smwo240/sensetech-wallv2/schematics/Air Module Schematic.jpg

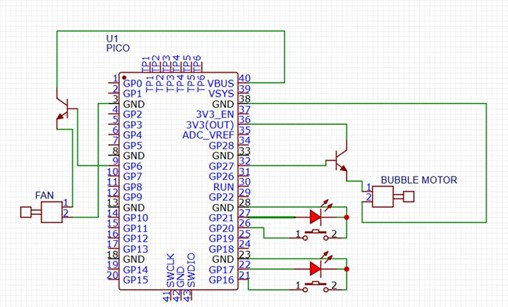
schematics/Air Module Schematic.jpg
