smwo240/sensetech-wallv2/README.md

# sensetech-wallv2
Project for University of Kentucky ECE Senior Design Course. Module Sensory Wall by Team 09 SenseTech.
