smwo240/sensetech-wallv2/schematics/README.txt

These are the schematics for the final version of this project presented at University of Kentucky's senior design day. 
The code reflects the usage of the pin mappings and devices present.
