smwo240/sensetech-wallv2/schematics/Light Module Schematic.jpg

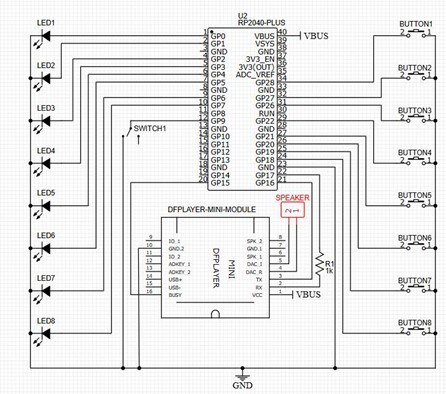
schematics/Light Module Schematic.jpg
