smwo240/sensetech-wallv2/schematics/Sound Module Schematic.png

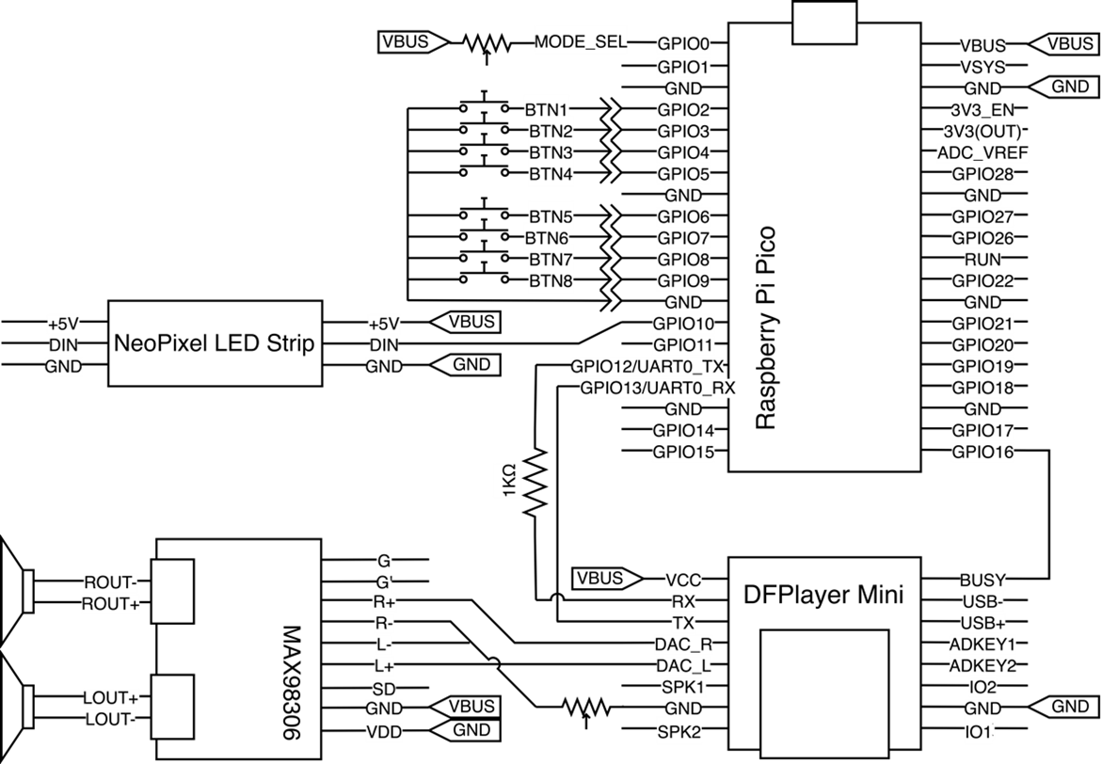
schematics/Sound Module Schematic.png
