smwo240/sensetech-wallv2/schematics/Vibration Module Schematic.png

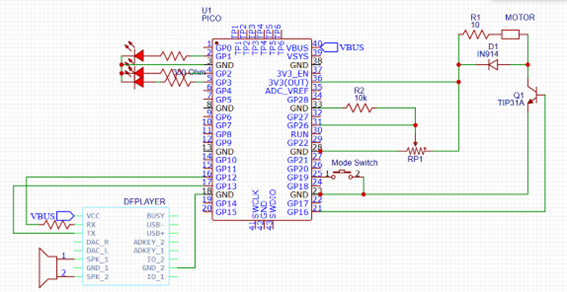
schematics/Vibration Module Schematic.png
