smwo240/sensetech-wallv2/3d-assets/Spring Holder Outer.stl

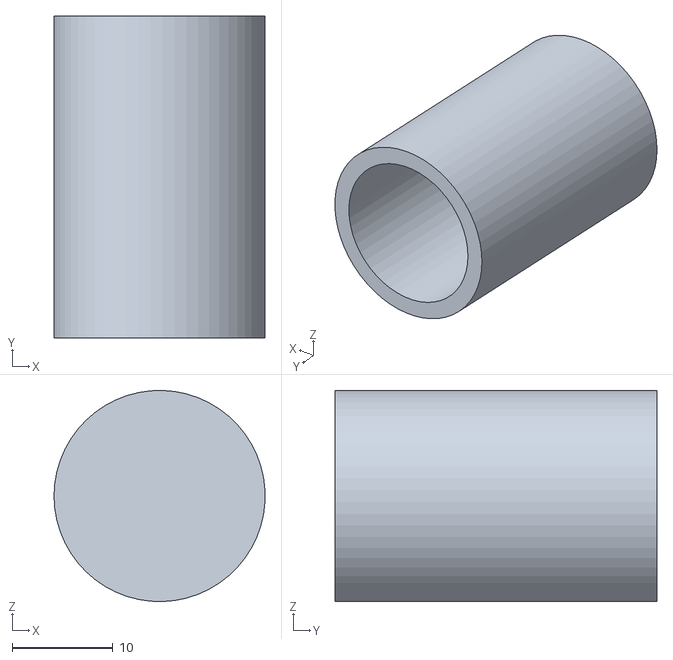
[picture p5: CAD file, 2025-05-11]
3d-assets/Spring Holder Outer.stl
21.0 x 32.0 x 21.0
