smwo240/sensetech-wallv2/3d-assets/SenseTechTopPlatev2.STL

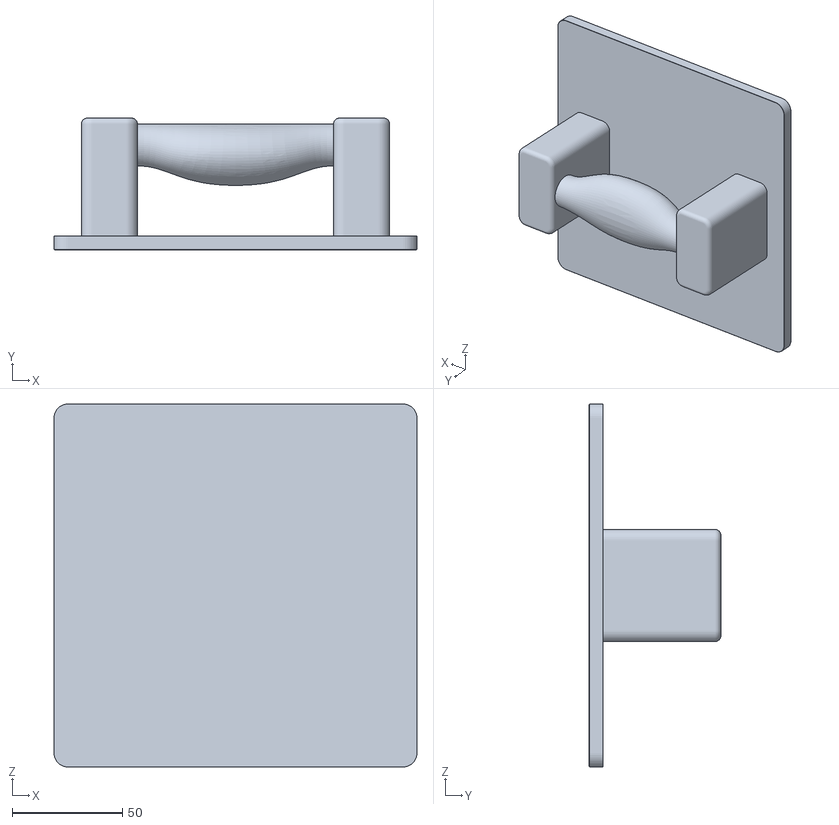
[picture p6: CAD file, 2025-05-11]
3d-assets/SenseTechTopPlatev2.STL
164.6 x 59.7 x 164.6
