smwo240/sensetech-wallv2/3d-assets/Motor Mount V2.stl

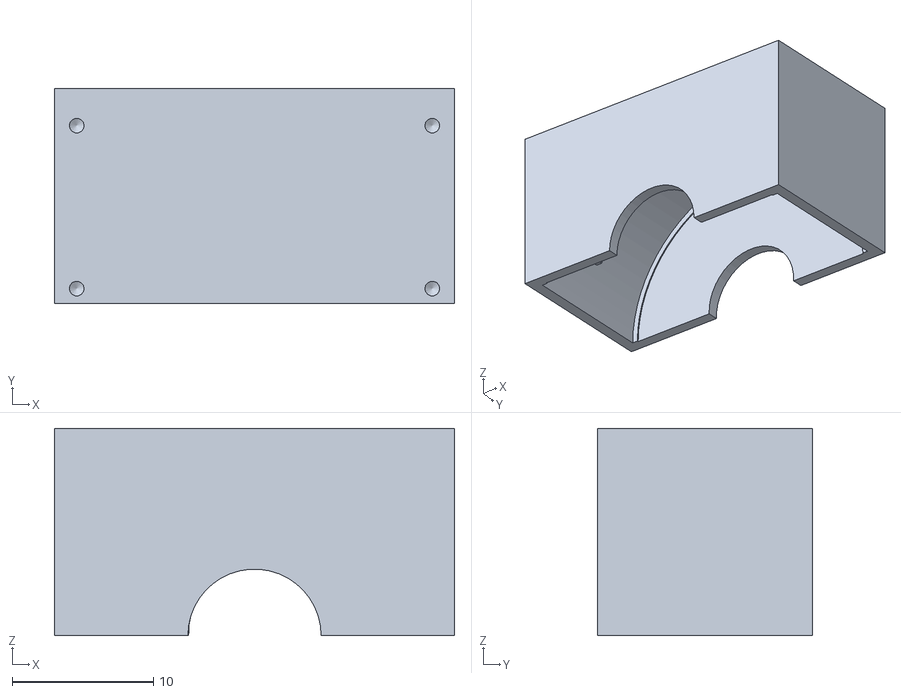
[picture p7: CAD file, 2025-05-11]
3d-assets/Motor Mount V2.stl
28.3 x 15.2 x 14.7
