smwo240/sensetech-wallv2/3d-assets/SenseTechSidePlatev2.STL

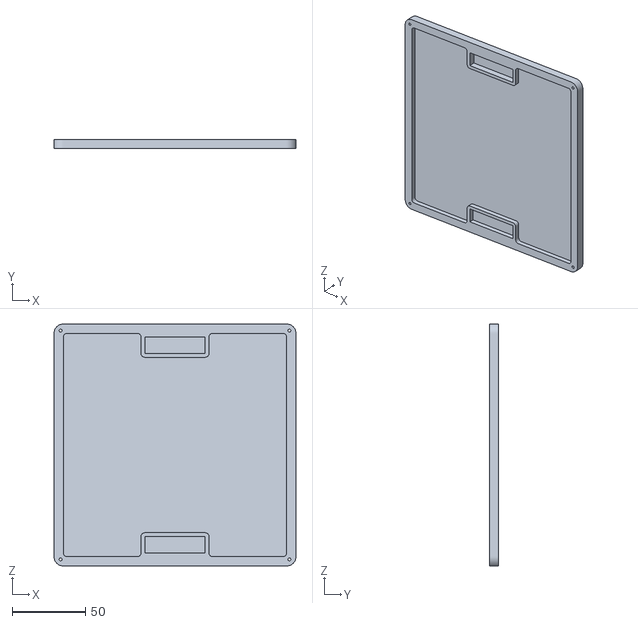
[picture p8: CAD file, 2025-05-11]
3d-assets/SenseTechSidePlatev2.STL
165.1 x 6.35 x 165.1
