smwo240/sensetech-wallv2/3d-assets/SenseTechBatteryPlatev2.STL

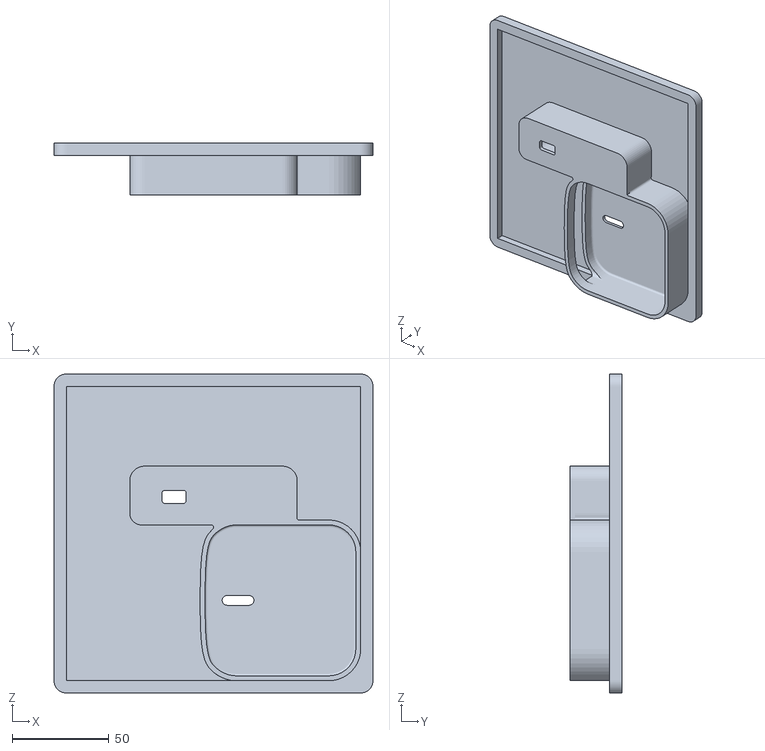
[picture p9: CAD file, 2025-05-11]
3d-assets/SenseTechBatteryPlatev2.STL
165.1 x 26.8 x 165.1
