smwo240/sensetech-wallv2/3d-assets/Spring Holder Inner.stl

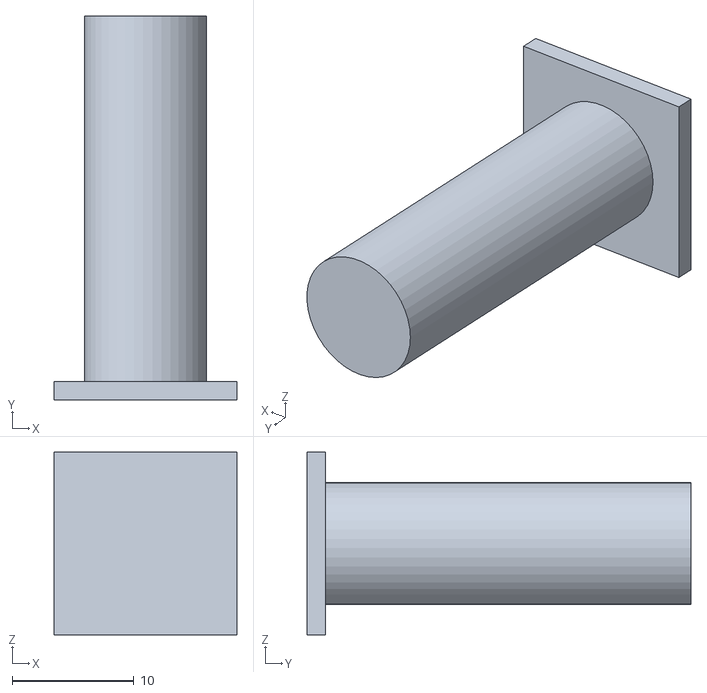
[picture p10: CAD file, 2025-05-11]
3d-assets/Spring Holder Inner.stl
15.0 x 31.5 x 15.0
