smwo240/sensetech-wallv2/(commit log)

2024-12-04 feat: main function and interrupts for light modul
2024-12-04 Create initializeTest.mpy
    Basic test to ensure clock is initialized and onboard LED/Button are functional.
2024-12-04 Create PWMexample.mpy
    basic PWM, make sure to include PWM library.
2024-12-04 Create ADCexample.mpy
    Simple Example to test ADC connection.
2024-12-04 Create DACexample.mpy
    DAC test code; no built in DAC with Pico so have to simulate it with PWM.
2024-12-04 Create AirModulemp.mpy
    Using PWM to run Air Module, rough draft.
2025-02-13 Update light-module.c
    Updated Pin#s for Hardware Update
2025-02-26 Create newairmodule
    Here is the code for the updated air module that utilizes a slide potentiometer instead of button inputs.
2025-03-11 Update ADCExample2.c
    Updated version of ADC template for all subprojects to use (In C/C++, compatible with Visual Studio)
2025-03-12 Update PWMEx.c
    Add additional functionality to file, compatible with Visual Studio instead of Thonny.
2025-03-13 Update pwm-test.c
    Merge with Nathan Microcontroller subproject
2025-03-24 added comments for toggle switch implementations
2025-03-26 toggle switches implementation
2025-03-26 added some LEDs to the vibration module setup
    [vibration-module.c]
2025-03-27 tested 4 simultaneous PWM outputs for the vibration module - GP16 and GP0 share a channel so I had to move my GPIO to different pins
    [pwm-test.c]
2025-03-27 Completely rewrote the program. Ranges on POT are now constants at top of program. LEDs get brighter to indicate position on POT and go to max brightness when new range entered. Pulse mode added - a 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
    [vibration-module.c]
2025-03-31 was going to test multiple ADC inputs using the pwm-test program but didnt get far
2025-04-01 fix: change pin numbers
    [light-module.c]
2025-04-01 added old light module program to our test directory to troubleshoot software issues - add features to this to progress forward with testing
    [pwm-test.c]
2025-04-01 using pwm-test.c to try something out with the light module given that the program stalls in the other project
    [mp3.c, mp3.h, pwm-test.c]
2025-04-13 pwm-test holds the current light module code build. vibration module had minor changes to accomodate the changes in the physical structure
    [pwm-test.c, vibration-module.c]
2025-04-14 pasted current in-use version of light module code into this directory for proper documentation.
2025-04-14 cleaned up air module code a little - might be changed so the buttons are on/off toggles instead of set time periods. Could also make it on/off with a timer that shuts it off after a set time anyway
2025-04-15 Update air-mod-battery-test.c
    comment descriptions
2025-04-15 Update light-mod-battery-test.c
    comment description
2025-04-15 Update vib-mod-battery-test.c
    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
2025-04-15 Update pwm-test.c
    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
2025-04-15 pwm testing for light module
2025-04-27 tried implementing the pwm onto the light module
2025-04-27 current version of light module code
2025-04-27 Update air-module.c
    change fan functionality to toggle instead of auto shutoff
2025-04-27 Update air-module.c
    add auto shutoff feature for air module, add blinking LED when auto shutoff is about to occur (25s into the 30s)
2025-04-27 added idle power light indicator
2025-04-27 feat: button/light code updates
2025-04-28 Create assembly instructions
2025-04-30 Create schematics directory
2025-04-30 Final schematic Files
2025-05-06 added instructions for initial prototype
